muel9560/wood_drying/media/ESP32-S3 PINOUT.jpg

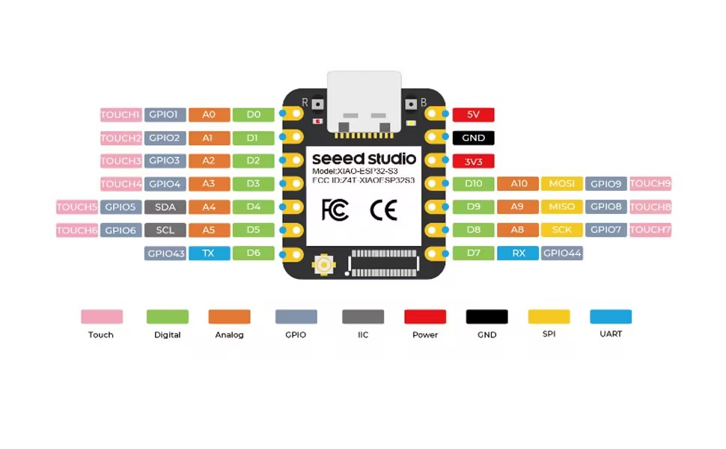
media/ESP32-S3 PINOUT.jpg
