muel9560/wood_drying/esphome/AUTORANGE.md

# Dual-range (auto-ranging) moisture read

Optional add-on for the final-drying endgame. Reads each channel on the default
100k pull-down; when a channel is dry enough that its reading sinks into the
ESP32-S3 ADC's noisy low-voltage floor, it re-reads on a 220k pull-down where
the same wood resistance produces a larger, cleaner voltage. See
[`../spice/README.md`](../spice/README.md) → "Component value selection" for the
numbers and [`../spice/wood_afe_autorange_sch.asc`](../spice/wood_afe_autorange_sch.asc)
for the wiring.

## Two firmware fixes this assumes (already shipped on the main channels)

Both are already applied to `updated_wood_moisture_node1.yaml`; keep them when you
paste the auto-range lambda below.

1. **Resistance solve uses R2 in the numerator.** The divider is
   `V = VCC · R2 / (R1 + R_wood + R2)`, so:

   ```cpp
   float r = (${r2_value} * 3.3f / v) - ${r1_value} - ${r2_value};   // R2, not R1
   ```

   An earlier version had `R1` there, which yields negative resistance and the
   `r <= 0` guard returns 28% — the sensor read ~28% for everything.

2. **Clamp MC, not resistance.** Compute `mc` from the curve, then clamp it to the
   valid band `[6, 28]`. An earlier version clamped *resistance*
   (`r > 1.5 MΩ → 6%`), but the curve puts 1.5 MΩ at 13.2% MC, so it floored every
   reading drier than ~13% to a bogus 6% — exactly the dry-end range the 220 kΩ
   path exists to measure.

## Hardware

Switchable-R2 auto-range front end

Two pull-downs from the ADC node (`sigb`, GPIO1), each grounded by its own GPIO
used as a switched ground — no extra chips:

| Resistor | From → to | Grounded by |
|---|---|---|
| R2_lo = 100 kΩ | `sigb` → GPIO10 | GPIO10 |
| R2_hi = 220 kΩ | `sigb` → GPIO11 | GPIO11 |
| Cadc = 22 nF (optional) | `sigb` → GND | — (feeds ADC S/H on the 220k range) |

- Select a range by driving that resistor's GPIO **LOW** (it becomes ground) and
  setting the other GPIO to **INPUT / hi-Z** (that resistor is disconnected;
  input leakage is ~nA against 100k+).
- GPIO10/11 are otherwise-unused ESP32-S3 pins; adjust if your board differs.

## Config additions

```yaml
substitutions:
  # ... existing ...
  r2_lo: "100000.0"          # default broadband range
  r2_hi: "220000.0"          # dry-end range
  autorange_v_thresh: "0.80" # on the 100k range, below this re-read on 220k
                             # (0.80 V ~ R_wood 300k ~ 9% MC)
  pin_r2_lo: "10"            # GPIO grounding the 100k pull-down
  pin_r2_hi: "11"            # GPIO grounding the 220k pull-down
  hi_extra_dwell: "200"      # extra ms settle on the 220k range (higher R -> slower)

esphome:
  on_boot:
    priority: 600
    then:
      - output.turn_off: excite_pin
      - output.turn_off: mux_en
      - lambda: |-
          // default to the 100k range at boot
          pinMode(${pin_r2_hi}, INPUT);
          pinMode(${pin_r2_lo}, OUTPUT); digitalWrite(${pin_r2_lo}, LOW);
```

## Auto-range channel lambda (example: CH-A00)

Drop-in replacement for a channel's `lambda:`. The only per-channel differences
are the MUX address lines (`mux_s0..s3`) and the log tag.

```yaml
  - platform: template
    name: "2in Calibbration Shallow"
    id: m_a00
    unit_of_measurement: "%"
    accuracy_decimals: 1
    icon: "mdi:water-percent"
    update_interval: ${scan_interval}
    lambda: |-
      // --- range-select helpers (raw GPIO switched grounds) ---
      auto range_lo = []() { pinMode(${pin_r2_hi}, INPUT);
                             pinMode(${pin_r2_lo}, OUTPUT); digitalWrite(${pin_r2_lo}, LOW); };
      auto range_hi = []() { pinMode(${pin_r2_lo}, INPUT);
                             pinMode(${pin_r2_hi}, OUTPUT); digitalWrite(${pin_r2_hi}, LOW); };

      // --- select this channel on the MUX (address 0) ---
      id(mux_en).turn_on(); delay(${bleed_delay}); id(mux_en).turn_off();
      id(mux_s0).turn_off(); id(mux_s1).turn_off(); id(mux_s2).turn_off(); id(mux_s3).turn_off();
      delay(${addr_delay});

      // --- correlated double sample on the default 100k range ---
      // A reference (excite OFF) taken before AND after the signal (excite ON)
      // brackets out the ADC offset, the electrode DC / polarization, and slow
      // drift: v = signal - mean(reference). See "Correlated double sampling".
      float vb0, vh, vb1;
      range_lo();
      id(excite_pin).turn_off(); delay(${read_delay}); vb0 = id(raw_adc).sample();
      id(excite_pin).turn_on();  delay(${read_delay}); vh  = id(raw_adc).sample();
      id(excite_pin).turn_off(); delay(${read_delay}); vb1 = id(raw_adc).sample();
      float v  = vh - 0.5f * (vb0 + vb1);
      float r2 = ${r2_lo};

      // --- dry? re-read (also CDS) on the 220k range (lifts V off the floor) ---
      if (!isnan(v) && v < ${autorange_v_thresh}) {
        range_hi();
        id(excite_pin).turn_off(); delay(${read_delay} + ${hi_extra_dwell}); vb0 = id(raw_adc).sample();
        id(excite_pin).turn_on();  delay(${read_delay} + ${hi_extra_dwell}); vh  = id(raw_adc).sample();
        id(excite_pin).turn_off(); delay(${read_delay} + ${hi_extra_dwell}); vb1 = id(raw_adc).sample();
        v  = vh - 0.5f * (vb0 + vb1);
        r2 = ${r2_hi};
        ESP_LOGD("moisture", "CH-A00 autorange -> 220k v=%.4f", v);
      }
      range_lo();  // leave in the default state

      ESP_LOGD("voltage", "CH-A00 v=%.4f r2=%.0f", v, r2);
      if (v >= 3.26f || v <= 0.03f) {
        ESP_LOGW("moisture", "CH-A00 open/short v=%.4f", v);
        return NAN;
      }

      // correct solve, using whichever R2 was active:
      float r = (r2 * ${vcc} / v) - ${r1_value} - r2;
      if (r <= 0.0f) return 28.0f;              // effectively short -> saturate high
      float mc = ${cal_a} - ${cal_b} * log10f(r);
      if (mc > 28.0f) mc = 28.0f;               // fiber-saturation ceiling
      if (mc < 6.0f)  mc = 6.0f;                // dry floor
      float t = id(stack_temp_c).state;         // sensor07_mer reports °F
      if (!isnan(t)) { float t_c = (t - 32.0f) * 5.0f / 9.0f;
                       mc -= ((t_c - ${temp_baseline_c}f) / 5.6f) * 0.5f; }
      else ESP_LOGW("moisture", "CH-A00 temp unavailable, skipping correction");
      return mc;
    state_class: measurement
```

## Correlated double sampling (CDS)

The read takes a reference sample with excitation **off**, the signal sample with
excitation **on**, and a second reference **off** — then uses
`v = vh − ½·(vb0 + vb1)`. Subtracting the reference cancels everything that is
common to both states: the ESP32-S3 ADC's offset, the DC the electrode/wood
junction builds up (polarization), and slow thermal or hum drift on the long
probe runs. Bracketing the signal with a reference *before and after* also
cancels linear drift across the reading window. This is the same trick CCD/CMOS
image sensors use to erase reset (kTC) noise. It matters most at the dry end,
where the real signal is only a couple hundred mV sitting on that pedestal.

Two practical notes:

- CDS trades offset rejection for a little more *random* noise (subtracting two
  noisy samples). Pair it with ADC averaging — set the `raw_adc` sensor to
  `samples: 4` (or 8) — to get both a flat baseline and lower noise.
- The **signal** sample must come after the node has settled (the
  `tau = C_wood·(R_wood ∥ (R1+R2))` dwell from `spice/wood_afe_ac.net`), but the
  two **reference** samples must be close enough in time that the pedestal hasn't
  moved. The `${read_delay}` (and `+ ${hi_extra_dwell}` on the 220k range)
  covers the settle; keep the whole three-sample burst tight.

## Why the 0.80 V threshold

From the simulations (`spice/wood_afe.net`, `spice/wood_afe_r2sweep.net`) on the
100k range:

| V(sigb) | R_wood | MC% | action |
|---|---|---|---|
| ≥ 0.80 V | ≤ 300 kΩ | ≥ ~9% | 100k reading is fine (mid ADC range) |
| < 0.80 V | > 300 kΩ | < ~9% | re-read on 220k (0.205 V → 0.42 V at 6%) |

Below ~9% MC the 100k reading has slid toward the ADC's noisy floor; the 220k
re-read puts it back in the linear zone. Above that, the extra range and dwell
buy nothing, so most channels most of the time take the single fast 100k read.

## Notes

- The 220k range's higher source impedance needs the `Cadc` cap and the extra
  dwell (`hi_extra_dwell`) — the `tau = C_wood·(R_wood ∥ (R1+R2))` trade-off from
  `spice/wood_afe_ac.net`. Tune `hi_extra_dwell` to your measured settling.
- This keeps the shipping design at 10k/100k; the 220k path is only ever used
  for channels that have already dried past ~9%.
- Calibrate each range independently — a channel read on 220k and the same
  channel read on 100k should agree at the handoff; if they don't, trim
  `cal_a`/`cal_b` or the resistor values, not the threshold.
