muel9560/wood_drying/media/moisture_psoc5lp_design.png

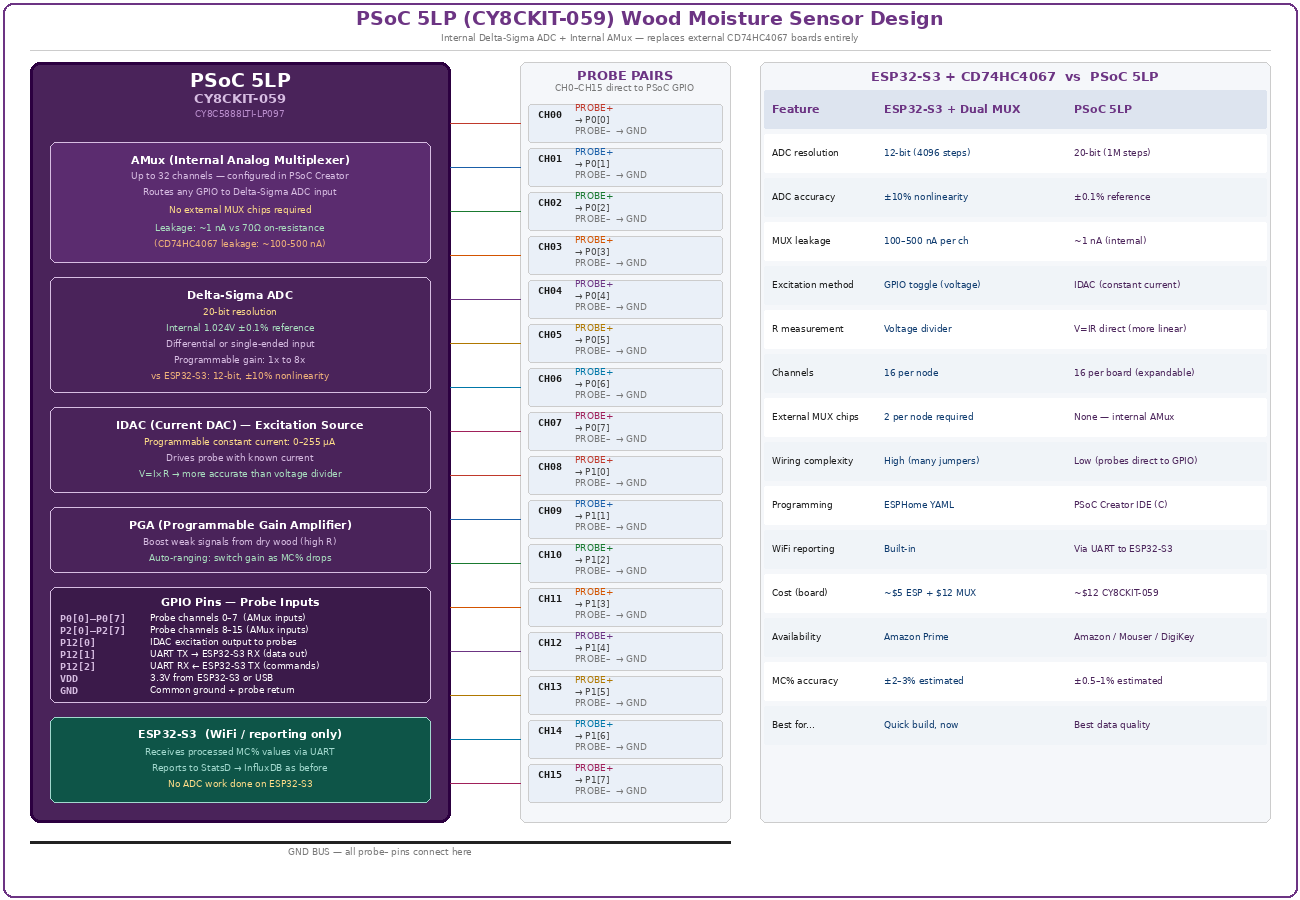
media/moisture_psoc5lp_design.png
