muel9560/wood_drying/media/moisture_sensor_pinout.png

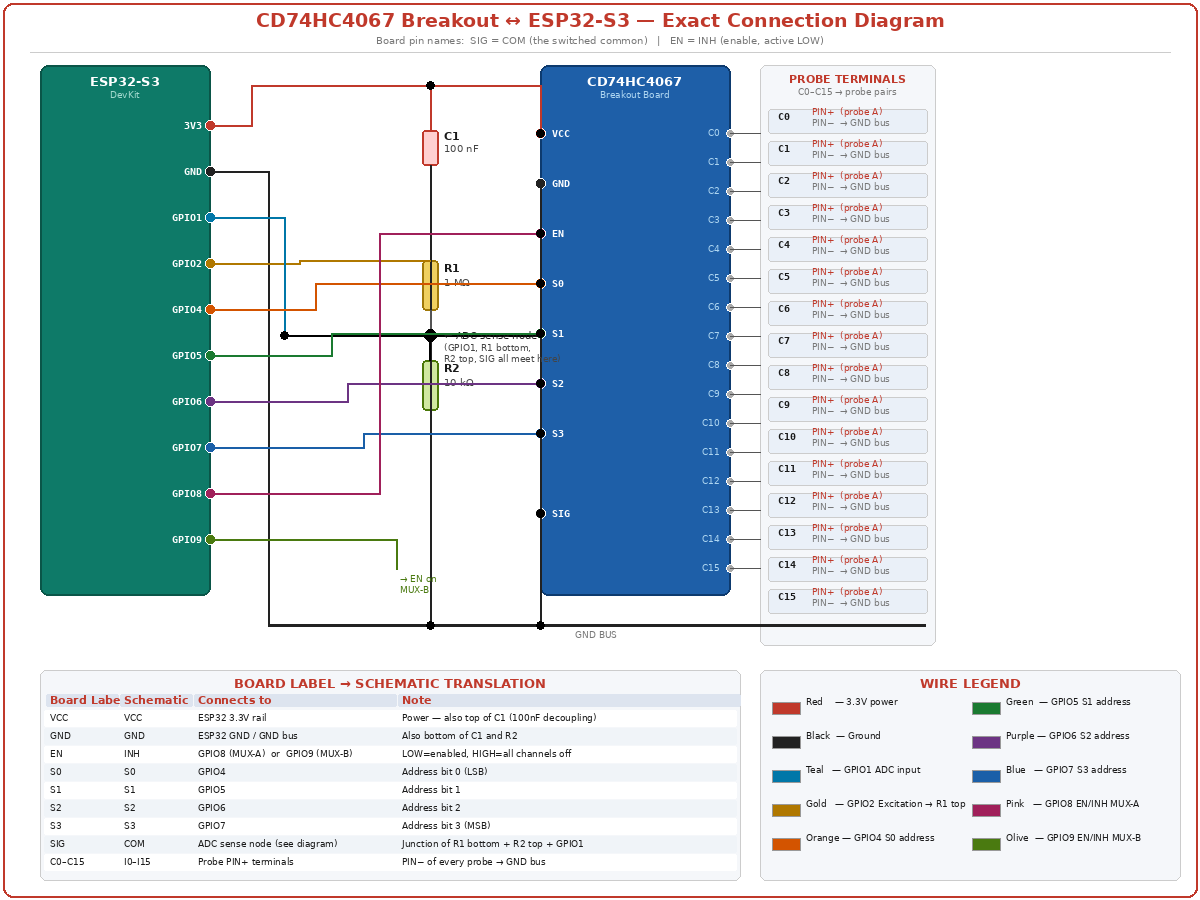
media/moisture_sensor_pinout.png
