muel9560/wood_drying/media/perfboard_bottom_view.png

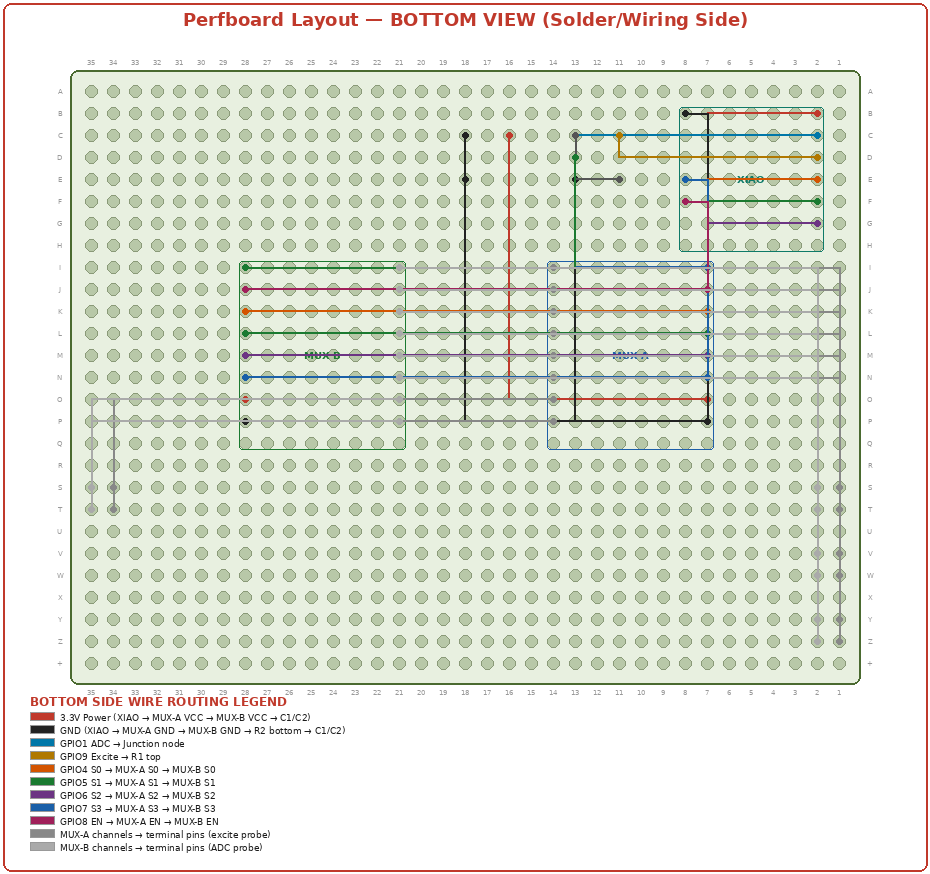
media/perfboard_bottom_view.png
