muel9560/wood_drying/media/perfboard_top_view.png

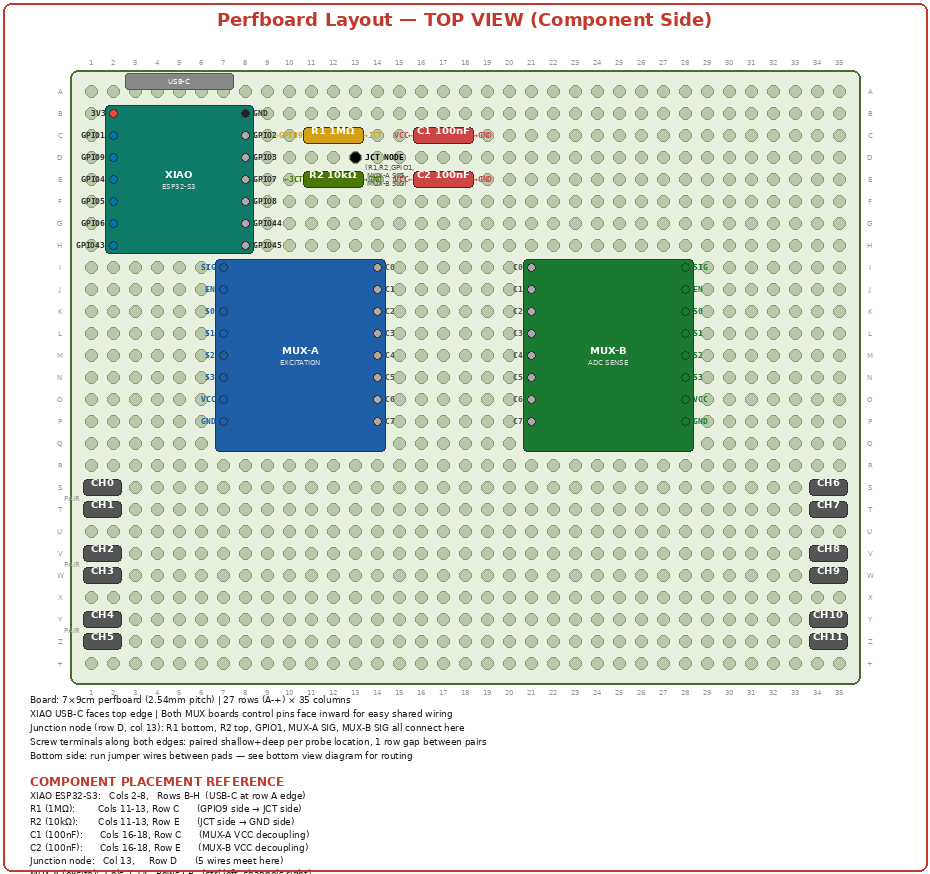
media/perfboard_top_view.png
