muel9560/wood_drying/media/moisture_autorange_wiring.pdf

# Wood-Moisture AFE — Switchable-R2 Auto-Range

One probe channel. A 220kΩ dry-range pull-down sits beside the stock 100kΩ; firmware picks the range per read.

GPIO9
excite 0/3.3V

R1
10k

MUX-A
CD74HC4067
Ron ≈ 70Ω

R_wood
probe pair in wood

MUX-B
CD74HC4067
Ron ≈ 70Ω

sigb
GPIO1
ADC sense

R2lo
100k

GPIO10
range-lo gnd

R2hi
220k

GPIO11
range-hi gnd

dry range

Cadc 22n
(220k S/H)
RANGE SELECT & SOLVE | = new dry-range path
100kΩ • default | GPIO10 OUTPUT LOW • GPIO11 INPUT hi-Z
220kΩ • dry end | GPIO11 OUTPUT LOW • GPIO10 INPUT hi-Z

Read on 100kΩ. If V(sigb) < 0.80V (≤ ~9% MC) → re-read on 220kΩ.
R_wood = R2 · VCC / V − R1 − R2 (use active R2)
220kΩ lifts 6% MC from 0.205V → 0.42V, off the ADC noise floor.

MUX address lines (S0–S3 = GPIO4–7), EN = GPIO8, shared across MUX-A/B (not shown).
