muel9560/wood_drying/media/moisture_dual_mux_wiring.png

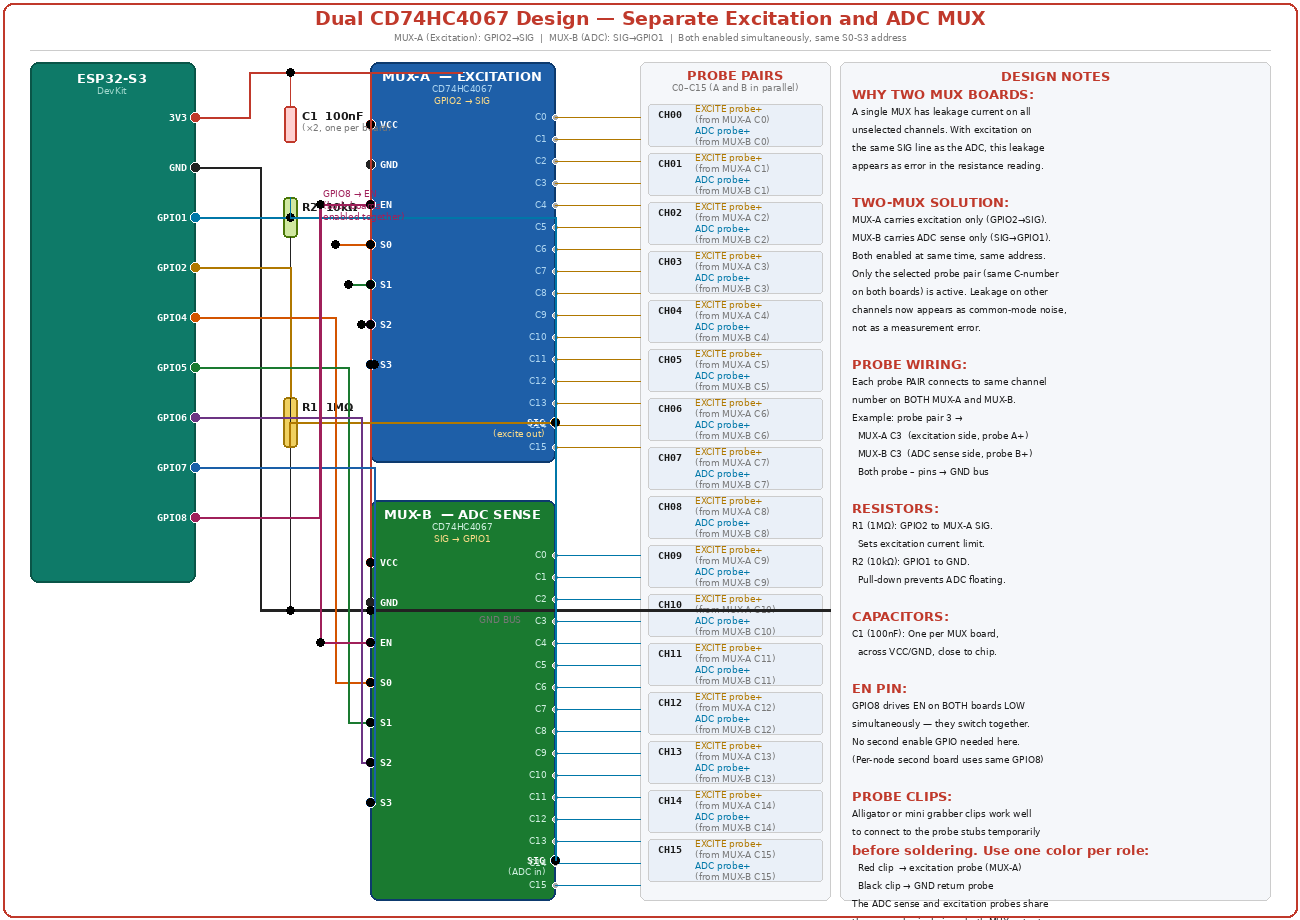
media/moisture_dual_mux_wiring.png
