muel9560/wood_drying/media/moisture_sensor_wiring.png

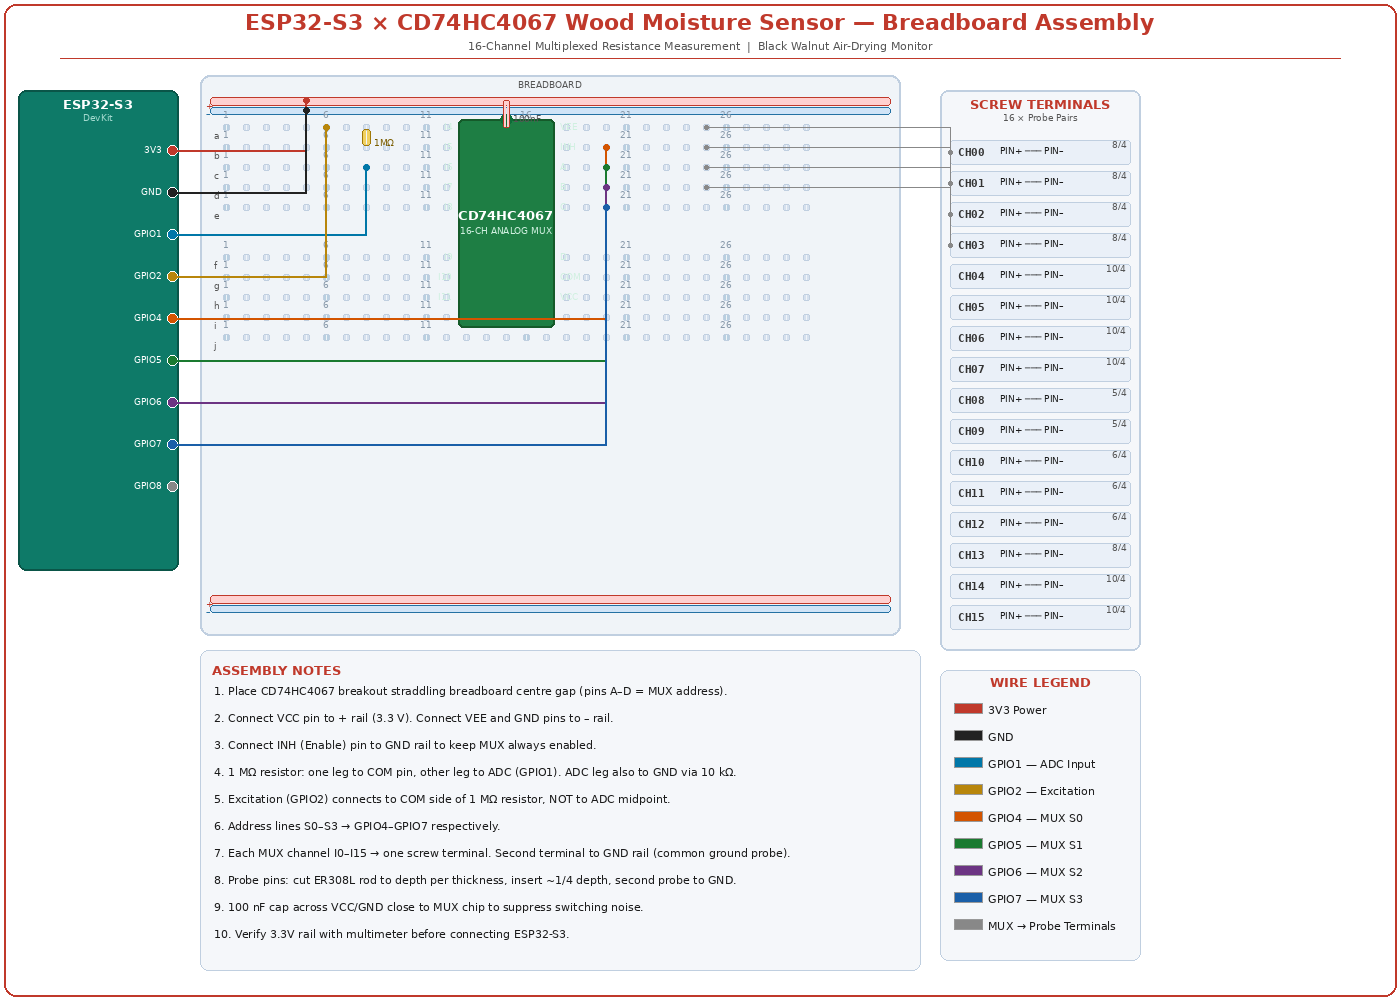
media/moisture_sensor_wiring.png
