muel9560/wood_drying/media/moisture_sensor_wiring_3node.png

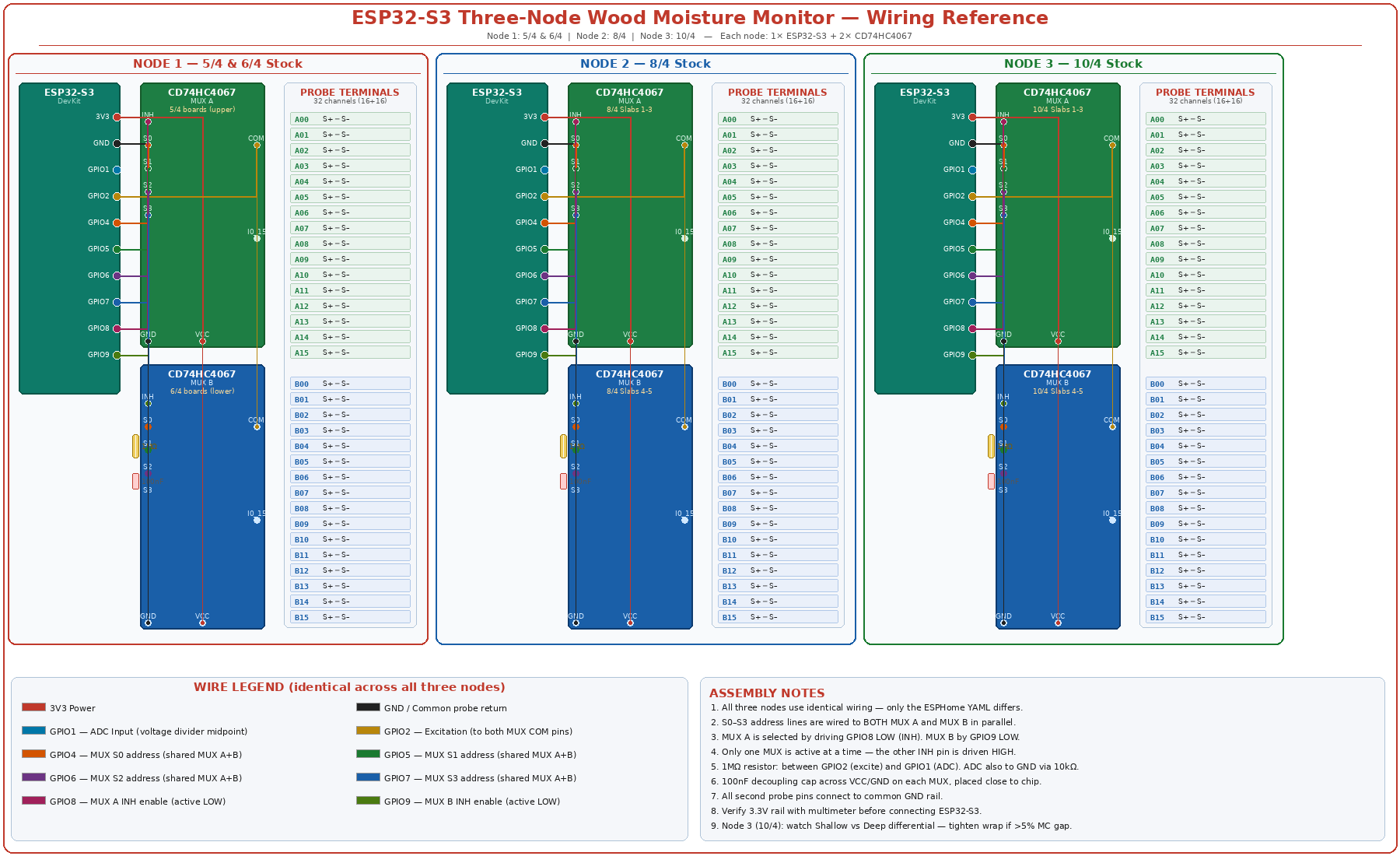
media/moisture_sensor_wiring_3node.png
