muel9560/wood_drying/spice/wood_afe_autorange_sch.asc

Cadc: cap; 22n
R1: res; 10k
R2hi: res; 220k
R2lo: res; 100k
RmuxA: res; 70
RmuxB: res; 70
Rw: res; 500k
VEXC: voltage; 3.3
Named nets: exc, 0, na, pa, pb, sigb, GPIO10, GPIO11
Wood Moisture AFE -- switchable-R2 auto-range front end
R1
MUX-A Ron
R_wood (probe pair)
MUX-B Ron
sigb = GPIO1 ADC
(+ Cadc feeds ADC S/H)
Cadc 22n (only needed on the 220k range)
;; RANGE SELECT (raw GPIO switched grounds):
;;   100k range: GPIO10 = OUTPUT LOW,  GPIO11 = INPUT (hi-Z)
;;   220k range: GPIO11 = OUTPUT LOW,  GPIO10 = INPUT (hi-Z)
;; read on 100k; if V(sigb) < ~0.8V (<=~9% MC) re-read on 220k
;; solve with the matching R2: R_wood = R2*VCC/V - R1 - R2
