muel9560/wood_drying/spice/wood_afe_sch.asc

R1: res; {R1}
R2: res; {R2}
Rlk: res; {Rleak}
RonA: res; {Ron}
RonB: res; {Ron}
Rw: res; {Rw}
VEXC: voltage; 3.3
Named nets: exc, 0, na, pa, pb, sigb
Wood Moisture AFE -- dual-MUX resistive divider (see spice/README.md)
R1
MUX-A Ron
R_wood
MUX-B Ron
sigb = GPIO1 ADC
.param R1=10k R2=100k Ron=70 Rleak=1e12
.step param Rw list 1 5k 8k 20k 35k 50k 100k 300k 500k 750k 1500k
.tran 1u 2m
.meas TRAN Vadc FIND V(sigb) AT 1m
