muel9560/wood_drying/(commit log)

2026-06-30 adding calibration and perfboard assembly
2026-06-30 adding logs from sensor testing
2026-07-02 fixed gpio pin change
2026-07-03 Add LTspice model of dual-MUX analog front-end
    Netlist model of the probe-side resistive divider (excite -> R1 -> MUX-A ->
    R_wood -> MUX-B -> R2 -> ADC). Validated on LTspice 17.2.4 against the
    expected-voltage table in wood_moisture_project.md (within a few mV).
    Includes wood_afe_singlemux.net demonstrating the off-channel leakage error
    the dual-MUX redesign fixes: several % MC of drift in the 500k-1.5M dry range.
2026-07-03 Add LTspice schematic (.asc) of the dual-MUX front end
2026-07-03 Decouple schematic and curated netlist filenames
    Rename wood_afe.asc -> wood_afe_sch.asc so the GUI's generated netlist
    (wood_afe_sch.net, now gitignored) no longer overwrites the hand-maintained
    wood_afe.net. Both describe the same circuit; verified identical output via CLI.
2026-07-03 Add AC-excitation + wood-capacitance settling model
    wood_afe_ac.net: PULSE excitation with C_wood in parallel with R_wood. Shows
    that an uncharged C_wood momentarily shorts R_wood at each edge, so sampling the
    ADC too soon makes dry wood read wet (1.5M reads 2.5V at 200us vs 0.205V
    settled). Settled values match wood_afe.net. Documents the ~5-tau dwell the
    firmware must respect before sampling, worst-case at the dry end.
2026-07-03 Add R2 component-selection study and dual-range guidance
    wood_afe_r2sweep.net sweeps the sense pull-down (100k/220k/390k) across the dry
    range. Documents why R1=10k/R2=100k are kept (R2 ~ geometric mean of the
    resistance span) and, for the final-drying endgame, an optional switchable-R2
    auto-ranging scheme (100k default, 220k when a channel reaches <=~9% MC) that
    lifts bone-dry readings off the ADC floor without a second system.
2026-07-03 Add switchable-R2 auto-range: wiring schematic + ESPHome logic
    - spice/wood_afe_autorange_sch.asc: 100k/220k switched-ground front end wiring
    - esphome/AUTORANGE.md: config additions + drop-in auto-range channel lambda
    (read on 100k, re-read on 220k below ~0.8V / ~9% MC), plus a fix for the
    resistance solve (R2 belongs in the numerator, not R1 -- current channels
    read ~28% for everything)
    - cross-links from spice/README.md
2026-07-03 fixing node1 logic and updated log
    [wood_moisture_node1.yaml]
2026-07-03 AUTORANGE: fold in correlated double sampling
    Both the 100k read and 220k re-read now take excite-off references before and
    after the excite-on signal and use v = vh - 0.5*(vb0+vb1), cancelling ADC
    offset, electrode polarization, and slow drift. Adds a CDS section noting the
    noise/averaging trade-off and the settle-vs-drift timing constraint.
2026-07-06 adding csv of weight during oven drying
    [weight.csv]
2026-07-06 A01: emit resistance + temp to statsd; fix F/C temp correction
    - Add ch01.resistance and ch01.temp statsd metrics via companion
    template sensors (update_interval: never, fed by the m_a01 lambda)
    - Publish raw pre-clamp resistance for oven-dry weight calibration
    - Convert sensor07_mer temp (F) to C before the correction; formula
    had been treating a Fahrenheit value as Celsius
    - Comment out dangling ch00.mc/m_a00 statsd ref (sensor not in this file)
    [updated_wood_moisture_node1.yaml]
2026-07-06 adding another weight and log
    [weight.csv]
2026-07-06 Fix dry clamp forcing dried wood to 6% MC
    The lambda clamped resistance (r > 1.5MΩ → return 6%), but the cal curve
    puts 1.5MΩ at 13.2% MC — so every reading drier than ~13% was floored to a
    bogus 6%. The oven-dried A01 piece reads ~3.4MΩ (v≈0.10V), which is correct
    and matches the spreadsheet (~12%), but the clamp threw it away.
    Clamp MC to the curve band [6,28] instead of clamping resistance to
    thresholds inconsistent with cal_a/cal_b. Applied to A00 and A01.
    [updated_wood_moisture_node1.yaml]
2026-07-06 Add 220k auto-range wiring diagram; sync docs
    - New media/moisture_autorange_wiring.svg: clean schematic of the
    switchable-R2 (100k/220k) front end with GPIO range-select and solve
    - README: add 'Auto-Ranging for the Dry End' section + diagram + file row
    - AUTORANGE.md: embed diagram; restate the two shipped firmware fixes
    (R2-in-numerator solve, clamp MC not resistance); update example lambda
    to the MC-clamp + F->C temp correction now in the live yaml
    - spice/README: link the visual diagram alongside the LTspice source
2026-07-06 adding 2 new weight readings and logs
    [weight.csv]
2026-07-07 Diagram: flag no-hard-ground on sigb; Cadc optional 10-47nF
    Common wiring trap: grounding the sigb rail (or bridging the optional Cadc
    footprint to ground) pins the ADC to 0V -> every channel reads short/open.
    Add a caution callout and note the cap is optional / 10-47nF.
2026-07-07 adding more weights and logs
    [weight.csv]
2026-07-07 Document oven-dry calibration run + refit black walnut curve
    First weight-based calibration run on the CH-A01 2in Cal Deep piece:
    - Method: extract logged R, cluster into weigh sessions, match to weight.csv,
    fit MC = a - b*log10(R) over the on-scale sessions
    - Oven-dry weight extrapolated to ~1481g (piece still drying ~1.3 g/h, not
    yet at constant weight) -> intercept provisional, slope stable
    - Provisional fit: MC = 45.8 - 7.53*log10(R), R2=0.94, valid ~7-14% MC
    - Shows shipped USDA curve (31.62/2.985) over-reads this walnut 5-9 points
    - Dry end (R>1M, <7% MC) unusable: ADC noise floor / hardware ceiling
    - Update ESPHome cal reference with provisional cal_a/cal_b
2026-07-07 Clamp MC after temp correction, not before
    Temp correction ran after the [6,28] clamp, so the 6% floor got pushed
    below 6 (e.g. 6.0 - 0.30 at 76F = 5.70%). Reorder: correct temp, then
    clamp last, so the floor is a true floor. Both channels, both node files.
    [validate_wood_moisture_node1.yaml]
2026-07-07 adding influxdb 15 minute csv dump for analysis
    [influxdb-statsd-woodstack-15min.csv]
2026-07-07 added data directory for data and telegraf/influx info and grafana directory for dashboards
    [influxdb-statsd-woodstack-15min.csv, weight.csv]
2026-07-07 Self-describing statsd schema: kind/stack/level + board facets
    - Telegraf: two templates keyed on literal kind (wood 11-seg / climate
    7-seg) so moisture no longer lands as a sensortype tag with the value in
    a generic 'value' field. Tags: kind, stack, level, thickness, board,
    spot, depth; fields mc|resistance (wood), temperature|humidity (climate)
    - Node1: rename the 2 live test channels to the new scheme (green piece
    shallow/deep), drop per-channel temp from statsd, wood scan -> 5 min
    - stack=shelf1/stack1/stack2, level=s1..s4 or high/mid/low
    [validate_wood_moisture_node1.yaml]
2026-07-07 Document StatsD/InfluxDB data schema in data/README.md
    Full tag+field reference for the woodstack measurement: kind/stack/level
    + board facets, metric name structure, Telegraf templates, ESPHome naming,
    a worked example, cadence, and migration notes. Linked from main README.
2026-07-07 Add Grafana dashboards: stacks overview + drying control
    - wood-stacks-overview.json: climate temp/humidity/EMC per stack-level,
    board MC over time, board list with sparkline + latest MC
    - drying-control.json: drying rate %/week (1%/week guardrail line) and
    shell-core differential (shallow-deep, 4/5% bands)
    - Flux queries against the new kind/stack/level schema; portable
    DS_INFLUXDB input; bucket/stack/thickness variables auto-populate
    - grafana/README.md with import steps + EMC temp-unit caveat
2026-07-07 Grafana: use a datasource template variable, not __inputs
    Imported dashboards frequently leave variable queries pointed at an
    unresolved datasource (${DS_INFLUXDB}), so the bucket/stack/thickness
    queries return nothing. Switch to a real ${datasource} template variable
    referenced by every panel and variable query. Robust bucket query (skips
    system _buckets). README: add Flux-vs-InfluxQL check + Data Explorer table
    tip for debugging variable queries.
2026-07-08 Add ADS1220 24-bit auto-ranging front-end: doc + ESPHome component
    - wood_moisture_ads1220_frontend.md: ratiometric constant-current design,
    PGA autorange, honest scope (~28-7.5% MC), and ADS1220/S06/S08 chip-choice
    decision table by per-node channel count
    - esphome/components/ads1220_moisture/: custom external component (SPI driver,
    register config, per-channel PGA autorange, ratiometric R, cal curve + temp,
    optional external CD74HC4067 muxing). DRAFT — needs hardware validation.
    README documents usage + the ADS124S08 variant delta
2026-07-10 Add per-board moisture dashboard with cascading probe filters
    Focused view for drilling into individual boards: cascading multi-select
    across stack, thickness, level, board, spot, and depth (each narrowed by
    the selections above it). Panels for MC over time, latest-MC table, raw
    resistance (log), and shell-core spread.
2026-07-12 ADS1220 front end: non-blocking, register readback, R_ref 200k
    Component changes:
    - Non-blocking. A reading is a settle delay plus one or two ~50ms
    conversions; all 16 channels share an update_interval and fire in the
    same loop iteration, so the old blocking update() would have stalled the
    main loop for ~2.4s every cycle and dropped the API connection. Channels
    now queue a request and the hub works through it from loop() as a state
    machine. The measurement maths is unchanged.
    - Park the mux between readings. The IDACs stay alive between single-shot
    conversions, so the last-selected probe was carrying 10uA continuously
    for the whole update_interval, DC-polarising its electrode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
    [ads1220_moisture.cpp, ads1220_moisture.h, wood_moisture_node1_ads1220.yaml]
2026-07-12 Add gitignore; pin the bench node to a static IP
    No gitignore meant the .esphome build cache and any secrets.yaml were one
    'git add .' away from being committed.
2026-07-13 Update bench procedure for the 220k reference actually on the bench
    The bench uses 220k for R_ref and 22k in place of 20k; 150k was unavailable.
    Gain is a function of R_dut/R_ref, so the expected gain column moves with R_ref:
    at 220k, 10k autoranges to 16 rather than 8. The doc treats an unexpected gain as
    a defect, so that row would have sent someone chasing a bug that is not there.
    Replace the 150k row with a series pair, and note that the 100k+100k option reads
    6.0% rather than the computed 5.9% because the dry floor clamps it -- near the
    ceiling R stays true while MC goes flat, which is the point worth seeing.
    Also compare against measured resistor values, not printed ones; with 1-5%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
2026-07-13 Log the gain-1 path
    The DEBUG line lived only in CONVERT2, which runs after a second conversion at
    gain > 1. When R_dut/R_ref is already large enough that gain 1 is the right
    answer, CONVERT1 publishes and returns without logging, so a successful reading
    looks exactly like a hang.
    With R_ref 220k the last 2x step ends at 82.5k, so on the bench everything above
    that -- 90k, 100k -- went silent while measuring correctly. Bench validation is
    the one time someone is reading the log line by line, and this is the range where
    the dry end lives.
    [ads1220_moisture.cpp]
